cmajames/led_controller_kicad/LED_Controller.kicad_pcb

## KiCad design LED_Controller.kicad_pcb (2016-03-04)

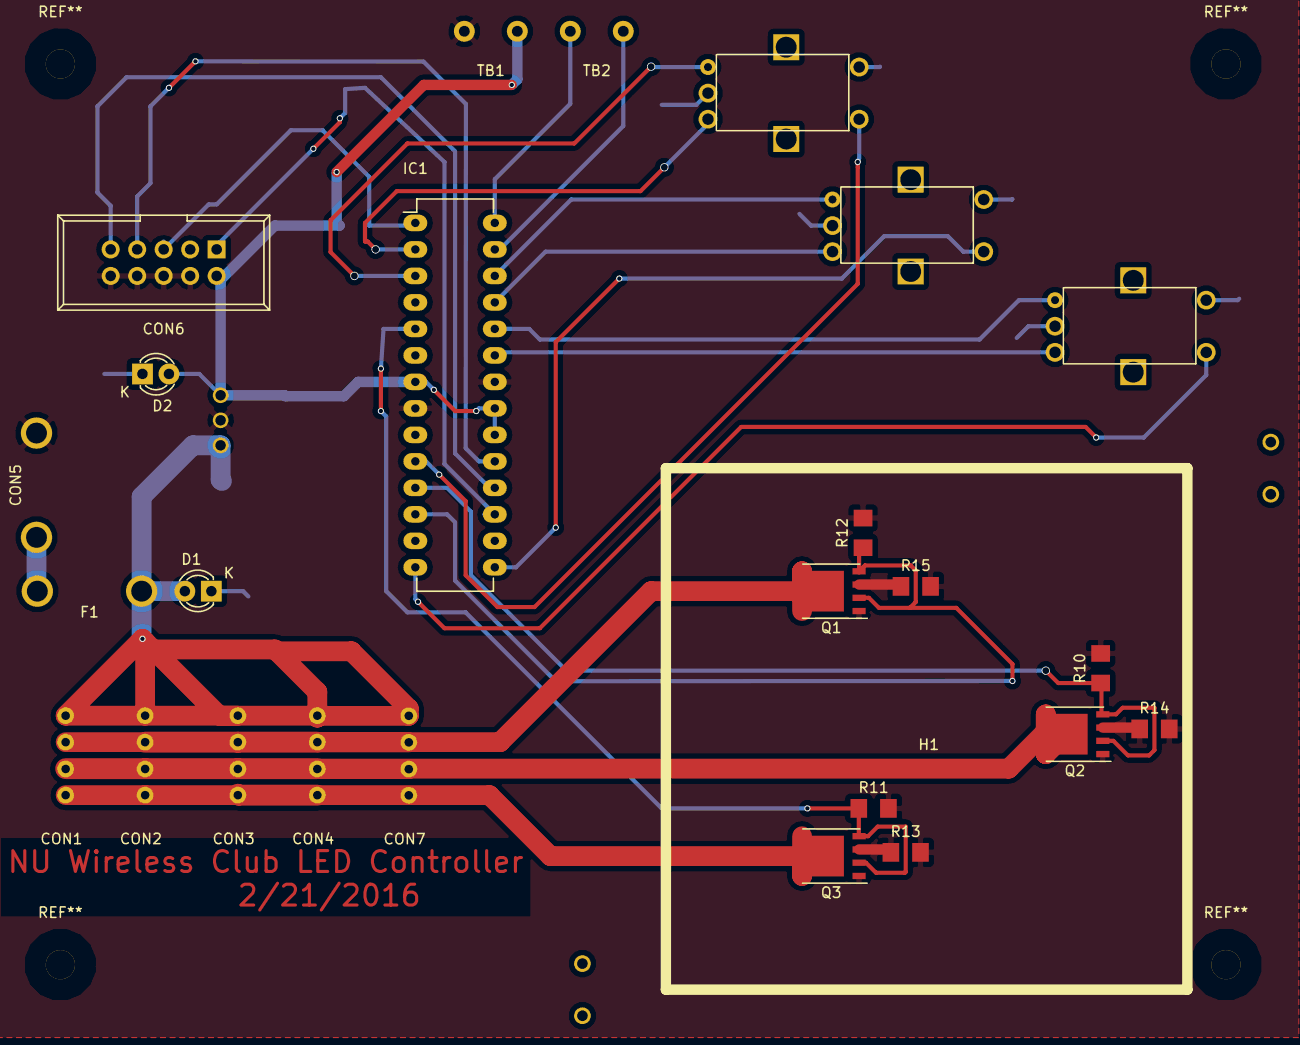
[picture p1: board LED_Controller.kicad_pcb from above]

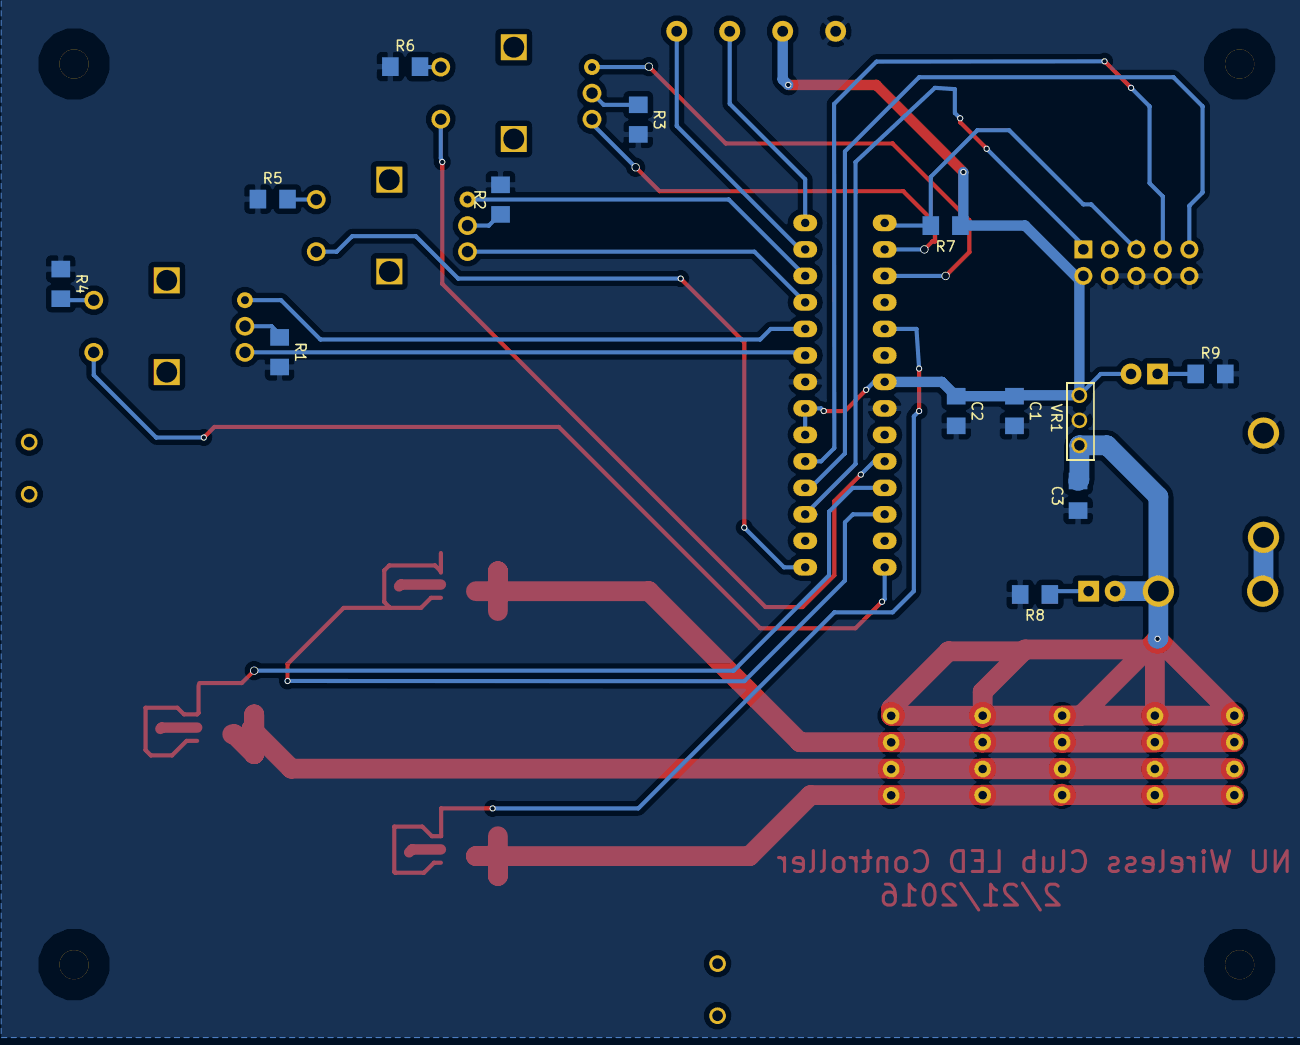
[picture p2: board LED_Controller.kicad_pcb from below]

Board: 2 copper layers, 39 parts (13 on the bottom side), 33 nets.

Parts:
C1, C3: 10uF; SMD_1206
C2: .1uF; SMD_1206
CON1, CON2, CON3, CON4, CON7: CONNECTOR; OUTPUT_HOLES
CON5: PWR_CON; 12V_PWR_HOLES
CON6: AVR-ISP-10; IDC_Header_Straight_10pins
D1, D2: LED; LED-3MM
E1, E2, E3: Rotary_Encoder; Rotary_encoder
F1: FUSE; 12V_PWR_HOLES
H1: Heatsink_50x50mm
IC1: ATMEGA328P-P; DIP-28_W7.62mm_LongPads
Q1, Q2, Q3: STS8DN3LLH5; SO-8_PowerPAK_Vishay_Single
R1, R2, R3, R4, R5, R6, R7, R10, R11, R12: 10k; SMD_1206
R8: 820; SMD_1206
R9: 499; SMD_1206
R13, R14, R15: 0; SMD_1206
TB1, TB2: Terminal_Block_2pin; Screw_Terminal
VR1: L7805CV

Connections:
+5V: C1.1, C2.1, CON6.2, D2.2, IC1.7, IC1.20, IC1.21, R7.1, TB1.1, VR1.3
+12V: C3.2, CON1.4, CON2.4, CON3.4, CON4.4, CON7.4, D1.2, F1.1, VR1.1
/BLUE_5V: IC1.12, Q1.2, Q1.4, R12.1
/BLUE_PWR: CON1.3, CON2.3, CON3.3, CON4.3, CON7.3, Q1.5
/GREEN_5V: IC1.11, Q2.2, Q2.4, R10.1
/GREEN_PWR: CON1.2, CON2.2, CON3.2, CON4.2, CON7.2, Q2.5
/MISO: CON6.9, IC1.18
/MOSI: CON6.1, IC1.17
/RED_5V: IC1.5, Q3.2, Q3.4, R11.1
/RED_PWR: CON1.1, CON2.1, CON3.1, CON4.1, CON7.1, Q3.5
/RST: CON6.5, IC1.1, R7.2
/SCK: CON6.7, IC1.19
/SCL: IC1.28, TB2.2
/SDA: IC1.27, TB2.1
GND: C1.2, C2.2, C3.1, CON5.2, CON6.4, CON6.6, CON6.8, CON6.10, IC1.8, IC1.22, Q1.1, Q1.3, Q2.1, Q2.3, Q3.1, Q3.3, R1.2, R2.2, R3.2, R4.1, R5.1, R6.1, R8.2, R9.2, R10.2, R11.2, R12.2, R13.1, R13.2, R14.1, R14.2, R15.1, R15.2, TB1.2, VR1.2
unnamed: CON5.1, F1.2
unnamed: D1.1, R8.1
unnamed: D2.1, R9.1
unnamed: E1.1, IC1.14
unnamed: E1.2, R4.2
unnamed: E1.3, R1.1
unnamed: E1.4, IC1.23
unnamed: E1.5, IC1.24
unnamed: E2.1, IC1.15
unnamed: E2.2, R5.2
unnamed: E2.3, R2.1
unnamed: E2.4, IC1.25
unnamed: E2.5, IC1.26
unnamed: E3.1, IC1.10
unnamed: E3.2, R6.2
unnamed: E3.3, R3.1
unnamed: E3.4, IC1.2
unnamed: E3.5, IC1.3
