cmajames/led_controller_kicad/(commit log)

2016-02-14 Added kicad files
    Added schematic, PCB, and library files
    [LED_Controller.kicad_pcb, LED_Controller.sch]
2016-02-15 Minor Changes
    Added a pull-up resistor to RST, to ensure chip is not reset during
    normal use. Some minor changes to the track layout.
    [LED_Controller.kicad_pcb, LED_Controller.sch]
2016-02-19 Changed to Common Anode, new status LEDs
    Updated schematic to reflect common anode LED strip, instead of common
    cathode.
    Added indicator LEDs to 12V and 5V power supply.
    Other minor routing changes. Still need to update footprint to make
    rotary encoder pins larger and probably change the Atmega footprint to
    the correct size.
    [LED_Controller.kicad_pcb, LED_Controller.sch]
2016-02-20 Atmega footprint updated, SS Pin changed, Heatsink footprint added
    Atmega328p footprint now correct size
    Added SS pin for SPI
    Made and placed footprint for 50mm square heatsink
    [LED_Controller.kicad_pcb, LED_Controller.sch]
2016-02-20 Changed passive sizes, re-routed traces
    Changed all passive components to 1206 size (that size is stocked in
    the lab, and it should be easier to solder without a scope)
    Created a general 1206 footprint for resistors and capacitors
    Re-routed traces to MOSFETs and rotary encoders, tried to minimize
    number of vias
    [LED_Controller.kicad_pcb, LED_Controller.sch]
2016-02-21 Rewired FETs
    corrected incorrectly wired MOSFETs in schematic, updated traces
    [LED_Controller.kicad_pcb, LED_Controller.sch]
2016-02-22 Changed some encoder pins, wired outputs for I2C instead os SPI, generated gerber for milling
    Re-adjusted resistors to ensure proper milling
    Removed 6-pin header for SPI
    Added schematic and component for 2-terminal screw block
    Wired SCL and SDA to terminal block, added another terminal block for
    GND and +5V and routed traces
    Re-wired and traced pins for rotary encoder 3 to PD0 and PD1 (they were
    connected to SCL and SDA before)
    Generated Gerber files for milling
    [LED_Controller.kicad_pcb, LED_Controller.sch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]
2016-02-24 More output pins for LED strips, mounting holes added
    Updated size of LED output holes for LED strips
    Added more output footprints for strips
    Added mounting holes to corners of board; are probably incorrect size,
    modify later
    Exported updated gerbers
    [LED_Controller.kicad_pcb, LED_Controller.sch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]
2016-02-24 Quick Fixes
    Connected unconnected trace to one of the LED strip holes
    Re-exported Gerber files
    [LED_Controller.kicad_pcb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]
2016-03-04 Minor Changes
    Removed hidden unconnected via
    Re-exported gerbers and drill file
    [LED_Controller.kicad_pcb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]
